joshmerritt/arduinoChickenCoopDoor/OriginalDoor_Stage1/README.md

# Chicken Coop Door: original model (one light sensor)

A refactored version of `coopDoor2024v1.ino` (on the `history` branch), for the original door's Arduino Uno. The wiring and behavior are the same as before. The code is reorganized so the settings are easy to find and change.

## Changing when the door opens and closes

The two light levels are at the top of `OriginalDoor_Stage1.ino`:

```cpp
const int BRIGHT_ENOUGH_TO_OPEN = 830;  // open when readings are at or below this
const int DARK_ENOUGH_TO_CLOSE = 900;   // close when readings are at or above this

const unsigned long CLOSE_DELAY_MS = 15UL * 60 * 1000;  // 15 minutes
```

**Lower readings mean brighter.**

Once it's dark enough to close, the door waits `CLOSE_DELAY_MS` (15 minutes) before closing, so late chickens can get in. To wait a different number of minutes, change the `15`. For no wait at all, set it to `0`.

To find good values:

1. Around dawn or dusk, plug the Uno into your laptop.
2. Open **Tools > Serial Monitor** at **9600 baud**. Every 15 seconds it prints a line like:

   ```text
   Light 652 | bright 2, dark 0 of 3 | door closed
   ```

3. Note the reading at the moment you'd want the door to move.

Keep a gap of at least 100 between the two numbers, so a cloudy evening doesn't make the door go back and forth. The comment above the settings lists the values you've used in past seasons.

To upload, select **Tools > Board > Arduino Uno** and click Upload. When the Uno restarts, it prints the levels it's using.

The other settings are in the same block:

| Setting | Value | What it controls |
|---|---|---|
| `READINGS_IN_A_ROW` | 3 | Readings in a row that must be past a level. After that, it waits one more reading and checks again before the motor starts. |
| `READING_INTERVAL_MS` | 15000 | Time between readings (15 seconds) |
| `MOTOR_POWER` | 90 | Motor speed (0–255) |
| `MOTOR_TIMEOUT_MS` | 17000 | How long the motor runs before giving up if it doesn't reach a switch (17 seconds) |
| `SWITCH_CONFIRM_MS` | 50 | How long a limit switch must read closed before the motor stops. Shorter blips of electrical noise are ignored. |
| `EXTRA_CLOSE_MS` | 500 | When closing, how much longer the motor keeps running after the bottom switch, so the door settles fully shut. Change it in steps of 50–100. Too much lets out extra cord, which can start winding onto the spool backwards. |
| `MOTOR_PRINT_INTERVAL_MS` | 250 | How often the Serial Monitor shows the motor's progress while it runs |
| `FAILED_MOVES_BEFORE_PAUSE` | 4 | Failed tries in a row before it pauses |
| `FAILURE_PAUSE_MS` | 17 minutes | How long it pauses |

## What it does

- **Reading the light:** it reads the light sensor every 15 seconds.
- **Opening:** after 3 bright readings in a row, it waits one more reading and checks the light and the door again. If both still agree, it opens the door.
- **Closing:** it works the same way, but it only closes once it has stayed dark enough for 15 minutes. Any brighter reading starts the 15 minutes over, so a passing storm cloud during the day won't shut the chickens in. After a power cut at night, it also waits the 15 minutes.
- **Partly open door:** it's opened if it's bright, or closed if it's dark.
- **Stopping the motor:** the motor runs until the door reaches the top or bottom switch. If the door doesn't get there within 17 seconds, it stops anyway. A switch has to read closed for 50 ms in a row, so a brief burst of electrical noise from the motor can't stop it early. When closing, the motor then runs another 500 ms so the door settles fully shut.
- **Failed close:** if a close fails, the next try runs the motor the opposite way. This frees the door if the cord has wound onto the spool backwards.
- **Repeated failures:** after 4 failed opens (or closes) in a row, it waits 17 minutes before trying again. Between failed tries there's a break of two readings (about 30 seconds). The close delay doesn't start over for retries.

## Serial Monitor

At 9600 baud you'll see one line per light reading. While it's waiting to close, the line shows a countdown:

```text
Light 950 | bright 0, dark 3 of 3 | door open | closing in 8 min
```

Whenever the door moves, you'll also see:

```text
Dark and the door isn't closed. Checking again before closing.
Light 905 | bright 0, dark 3 of 3 | door open
Closing door
  motor on, running down
  motor running 250 ms | at top: yes | at bottom: no
  motor running 500 ms | at top: no | at bottom: no
  ...
  switch reached, running 500 ms more
  motor stopped after 6050 ms (switch reached)
Door closed
```

If a run shows **switch blips ignored**, electrical noise from the motor is reaching the switch wires. It's harmless now, but it's worth knowing about. If the line **Coop door starting** shows up right after the motor starts, the Uno is restarting when the motor turns on. That points to a power problem rather than the code.

## Black box (troubleshooting)

The Uno keeps a log of its last 85 events in its EEPROM memory, which survives power cuts:
- **Every restart:** a restart number, plus the Uno's supply voltage.
- **Every motor run start:** open or close, the motor direction, the supply voltage, the light reading, and which switches read closed.
- **Every motor run end:** why it stopped (switch reached or timed out) and how long it ran. It also records the lowest supply voltage during the run, the switch blips it ignored, and which switches read closed.

**To read it:**
1. Unplug the driver's power.
2. Plug the Uno into the laptop.
3. Open the Serial Monitor at **9600 baud**.

The Uno restarts and prints the log first. That can take about 10 seconds. To print it again later, type **L** and press **Send**.

```text
=== Black box: last 3 events, oldest first ===
RESTART #1 | supply 4.24 V
  310 s after restart: CLOSE started, motor down | supply 4.24 V | light 883 | at top: yes | at bottom: no
  320 s after restart: stopped after 10150 ms (switch reached) | lowest supply 4.24 V | switch blips ignored: 0 | at top: no | at bottom: yes
=== End of black box ===
```

What the patterns mean:

| You see | What it means |
|---|---|
| `stopped after` about 10000 ms `(switch reached)`, then `at bottom: yes` | A normal close. |
| `CLOSE started` followed straight away by `RESTART` | The Uno restarted when the motor started. That's a power problem. |
| `stopped after` a few hundred ms `(switch reached)` with `at bottom: no` | The bottom switch read closed while the motor ran, even though the door wasn't down. That's a wiring or switch problem. |
| `lowest supply` well below the normal reading | The motor's start pulls the Uno's power down. |

The supply readings are approximate (about ±10%). Expect about 4.2 V when the Uno is powered from the driver through Vin, or about 5 V on USB.

## Wiring (unchanged)

| Uno pin | Connected to |
|---|---|
| 9 | driver PWM (motor speed) |
| 6 | driver IN1 (HIGH = door up) |
| 7 | driver IN2 (HIGH = door down) |
| 12 | bottom switch (other wire to GND) |
| 13 | top switch (other wire to GND) |
| A0 | light sensor (other leg to GND) |
| Vin / GND | driver 5VO / COM |

## Differences from coopDoor2024v1

The door does the same things. These small differences were all checked in a simulation that ran both versions side by side:

- **Motor timeout:** it's now 17 seconds of real time. The old limit was 450 loop passes, and its length depended on how fast the Uno printed to the Serial Monitor. That worked out to about 17.3 seconds.
- **Switch noise:** a switch must read closed for 50 ms before the motor stops. The old code printed so much while the motor ran that it only checked the switches about every 38 ms. That accidentally made it ignore most noise; this setting does the same job on purpose.
- **Powering up in daylight:** it waits for 3 real readings plus the extra check before opening. The old code's empty reading history counted as "bright", so it could open sooner after power-up.
- **Both switches closed at once:** if both switches read closed (a wiring fault), it leaves the motor alone. The old code pulsed the motor every 10 seconds.
- **Failure pause:** the pause after repeated failures is 17 minutes. It was 1,000,000 ms, about 16.7 minutes.
- **Serial Monitor output:** it's easier to read: one line per reading, and the motor's progress while it runs.

## Next: WiFi (stage 2)

A later step will move this door to an ESP8266 (NodeMCU) board. It adds a status page, Open/Close buttons on your phone, and notifications. That version, and a step-by-step upgrade guide, are in [`../OriginalDoor_Stage2_WiFi`](../OriginalDoor_Stage2_WiFi). The door logic stays the same, so carry over the light levels you tune here.
