joshmerritt/arduinoChickenCoopDoor/(commit log)

2019-05-09 Two Switch Version
2026-10-03 Refactor original door sketch (stage 1, Uno)
    Rewrite coopDoor2024v1.ino as ChickenCoopDoor_OneSensor with the same
    wiring and door behavior, reorganized so settings are easy to tweak:
    - Light levels, timing and motor settings grouped at the top, with the
    past threshold values kept in a comment
    - Pins named after the XY-15AS driver inputs (PWM, IN1, IN2)
    - Motor timeout is 17 s of real time instead of a loop count whose
    length depended on Serial print speed (450 passes was ~17.3 s)
    - Door moves after 4 agreeing readings in a row, the same as the old
    3 readings plus a recheck
    - One readable Serial Monitor line per reading (9600 baud)
    Checked side by side with the 2024 sketch in a simul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
2026-10-05 Give each sketch a unique name by door
    Every sketch now lives in a folder named after the door it runs
    (Arduino needs the folder and .ino names to match):
    - ChickenCoopDoor_OneSensor/ -> OriginalDoor_Stage1/
    - ChickenCoopDoor_Refactored.ino -> NewDoor_TwoSensor/
    - coopdoor2.0.ino -> OriginalDoor_2020/
    File contents are unchanged apart from the stage 1 README's reference
    to its own sketch name.
2026-10-05 Add stage 2: original door on an ESP8266 with WiFi
    OriginalDoor_Stage2_WiFi runs the same door logic as stage 1 on a
    NodeMCU (ESP8266), adding a status page with Open/Close buttons and
    ntfy phone notifications. It isn't deployed yet. UPGRADE_GUIDE.md and
    wiring-esp8266.svg walk through moving the door from the Uno, fitted
    to the XY-15AS driver and HiLetgo NodeMCU in use.
    WiFi details go in arduino_secrets.h, which .gitignore keeps out of the
    repo; arduino_secrets.example.h is the template.
    The main README now lists which folder is which door.
2026-10-05 Fix compile errors in older Arduino IDEs
    Arduino IDEs before 1.6.6 insert function prototypes at the top of
    the sketch, before any types it defines, so functions that took the
    MotorDirection enum (and stage 2's MoveTrigger/DoorCommand) failed with
    "'MotorDirection' was not declared in this scope". Use named int
    constants instead.
    Verified by emulating the old IDE's preprocessing: it reproduced the
    reported errors before the change and compiles cleanly after. The
    door's behavior is unchanged: all simulated scenarios give identical
    results before and after, for both stage 1 and stage 2.
    [OriginalDoor_Stage1.ino, OriginalDoor_Stage2_WiFi.ino, wifi.ino]
2026-10-05 Fix stage 1 door not closing; restore re-check and motor logging
    The refactored motor loop checked the limit switch thousands of times a
    second, so a brief blip of electrical noise from the motor on the switch
    wires looked like the door reaching the switch. The motor stopped after
    a short pulse, reported "Door closed", and retried. The 2024 code only
    sampled the switch about every 38 ms (because of its Serial printing),
    which hid that noise.
    - A switch must now read closed for 50 ms (SWITCH_CONFIRM_MS) before
    the motor stops; shorter blips are counted and reported
    - Restore the explicit step from the 2024 code: after 3 readings past
    a level, wait one more reading and re-check the light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
    [OriginalDoor_Stage1.ino]
2026-10-05 Run the motor a little longer after the bottom switch when closing
    The door was stopping slightly short of fully shut. Add EXTRA_CLOSE_MS
    (default 200 ms): once the bottom switch is confirmed, the motor keeps
    closing for that long before stopping. Opening still stops right at the
    top switch. The Serial Monitor shows "switch reached, running 200 ms
    more" so the setting is easy to tune.
    [OriginalDoor_Stage1.ino]
2026-10-05 Add a black box log to stage 1
    The door still pulses briefly instead of closing in the field, and the
    Serial Monitor can't be watched while the motor driver is powered. The
    sketch now records each restart and each motor run in EEPROM (the last
    85 events) and prints the log at startup, or when L is sent.
    Each run records open/close, motor direction, why it stopped (switch or
    timeout), how long it ran, which switches read closed, ignored switch
    blips, the light reading, and the Uno's supply voltage before and at
    its lowest during the run, measured with the internal 1.1 V reference.
    A run start followed directly by a restart shows a power reset.
    Door behavior is unchanged in simulation (47 of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
    [OriginalDoor_Stage1.ino]
2026-10-10 Adjust light thresholds and motor parameters
    Updated brightness thresholds and motor settings for door operation.
2026-10-10 Replace the 33-minute close delay with a 15-minute dark timer
    The delay(2000000) in closeDoor() waited about 33 minutes (not 15),
    ran the motor afterwards without re-checking the light or door, and
    made every retry wait the full delay too.
    Add CLOSE_DELAY_MS (15 minutes): the door closes only once it has
    stayed dark enough for that long. A brighter reading restarts the
    wait, so a daytime storm cloud doesn't shut the door, and retries after
    a failed close don't wait again. The Serial Monitor shows a countdown
    ("closing in 8 min").
    Also fix the READING_INTERVAL_MS comment (15 seconds) and update the
    README for the new light levels, motor power and extra close time.
    Checked in simulation: cl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
    [OriginalDoor_Stage1.ino]
2026-10-10 Add black box log for door operations
    Added black box log for door events including motor actions and supply voltage.
